AlecVercruysse/6thsense/paper/assets/ap1.pdf

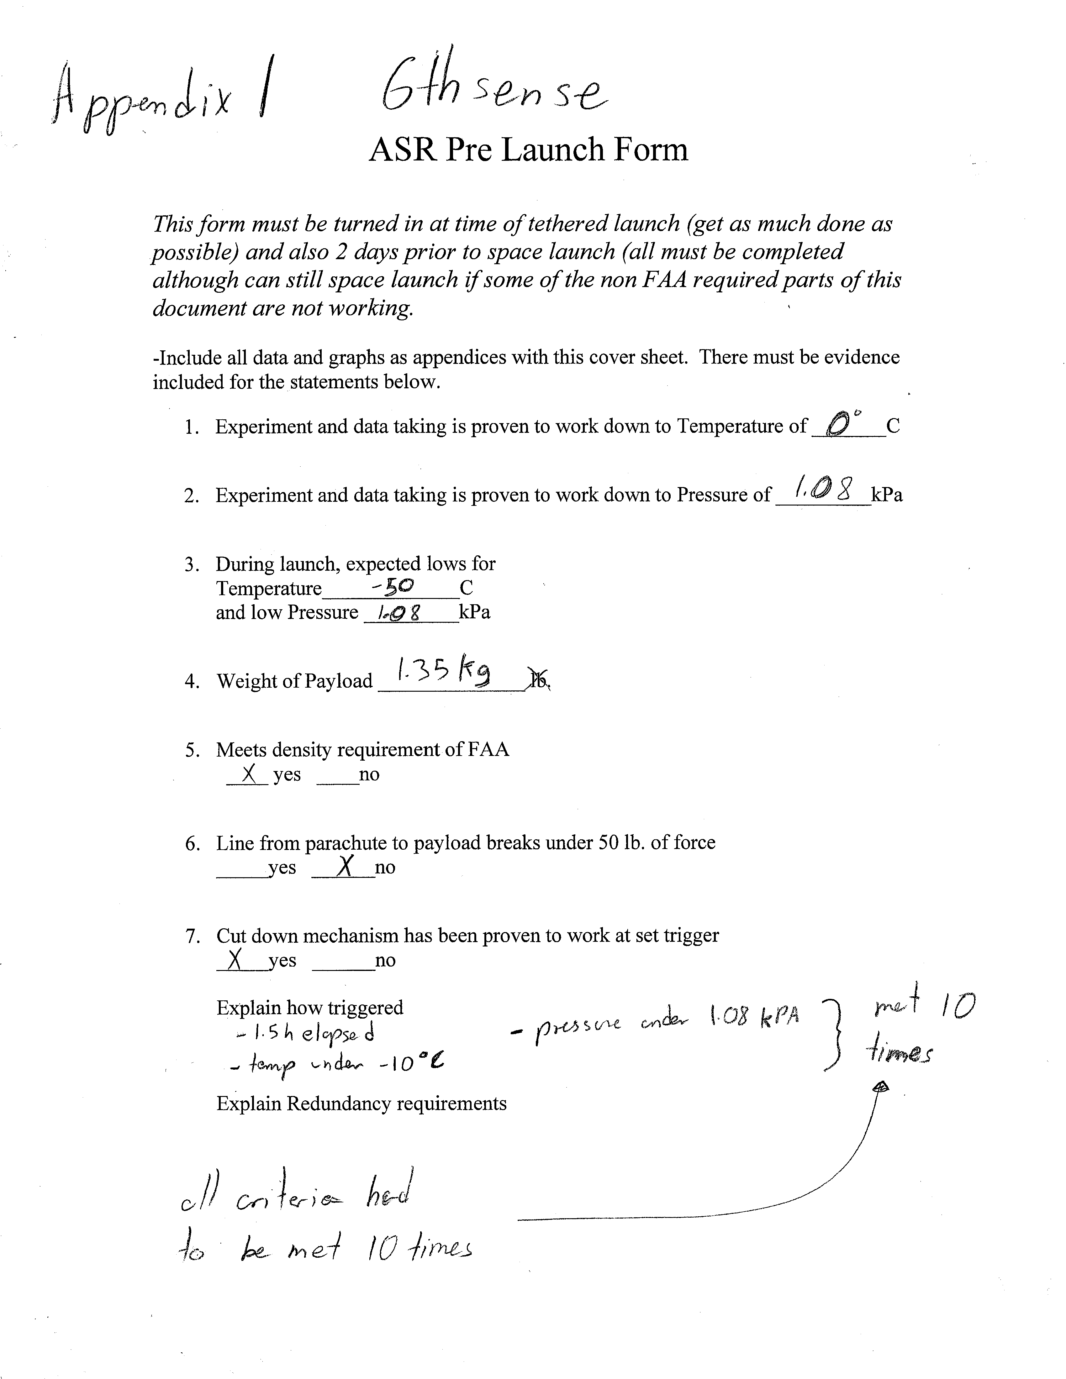
[picture p11: page 1]
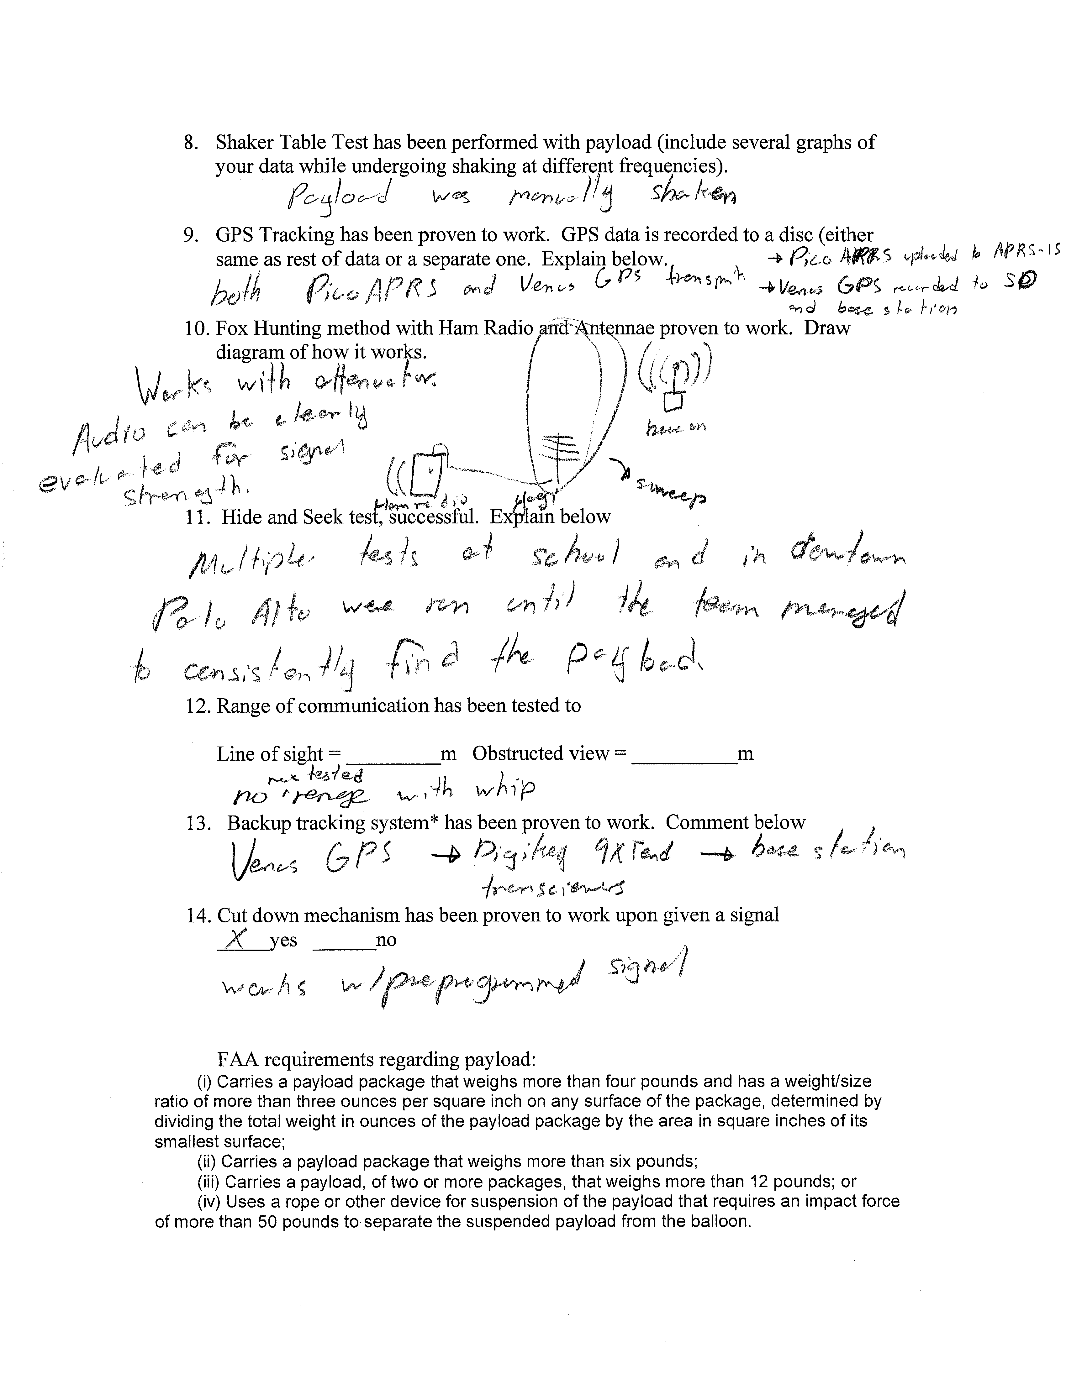
[picture p12: page 2]
