AlecVercruysse/6thsense/paper/assets/cad4.pdf

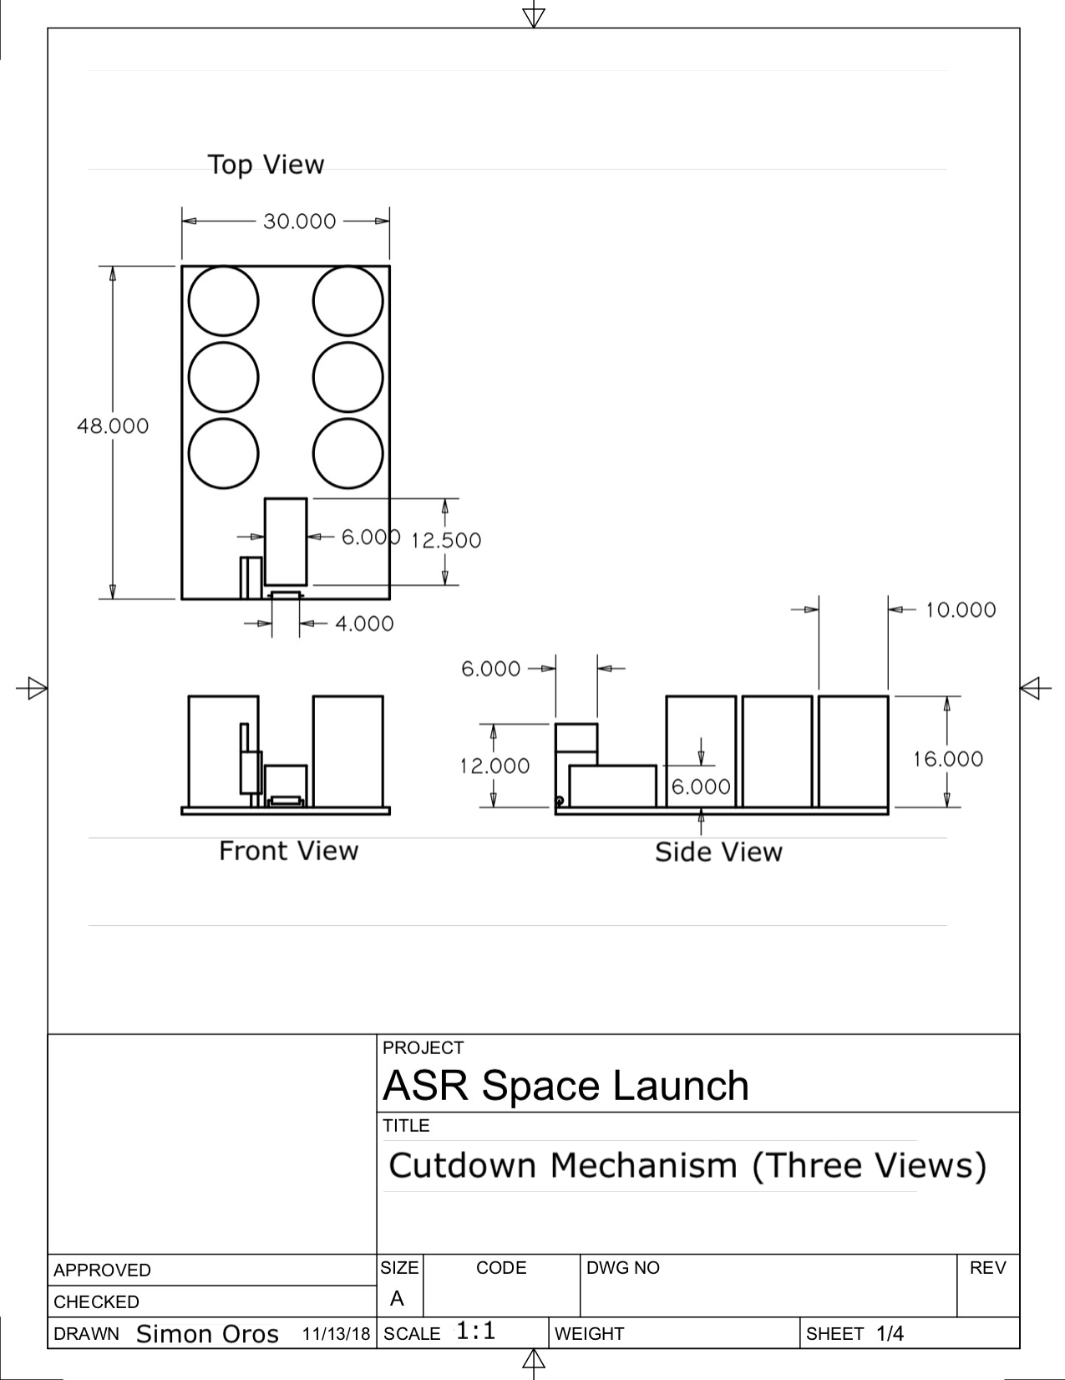
[picture p13: page 1]
