AlecVercruysse/6thsense/paper/assets/appendix2.png

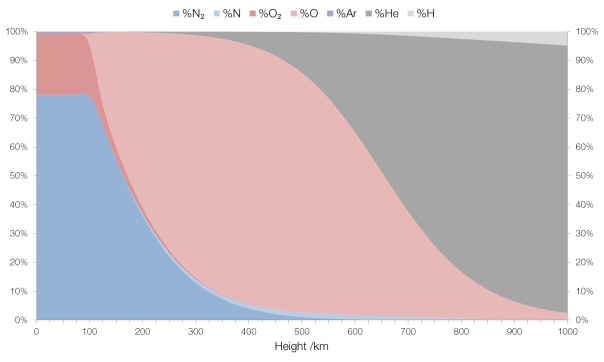
paper/assets/appendix2.png
