AlecVercruysse/6thsense/paper/assets/appendix3.png

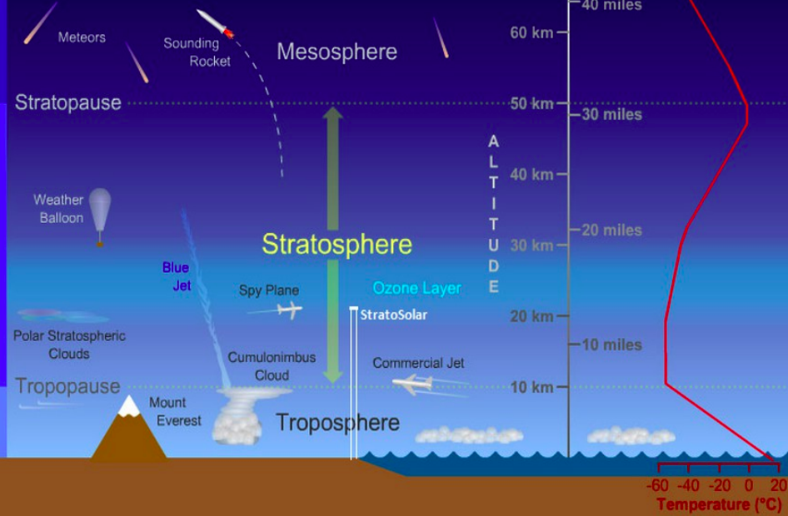
paper/assets/appendix3.png
