AlecVercruysse/6thsense/paper/assets/loop_flow.jpg

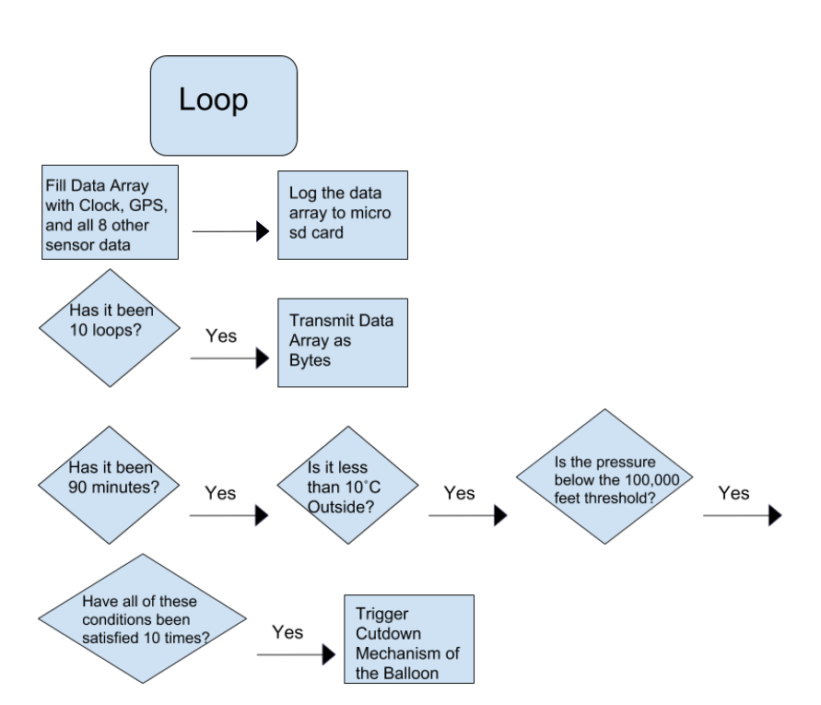
paper/assets/loop_flow.jpg
