AlecVercruysse/6thsense/paper/assets/nasa_model.gif

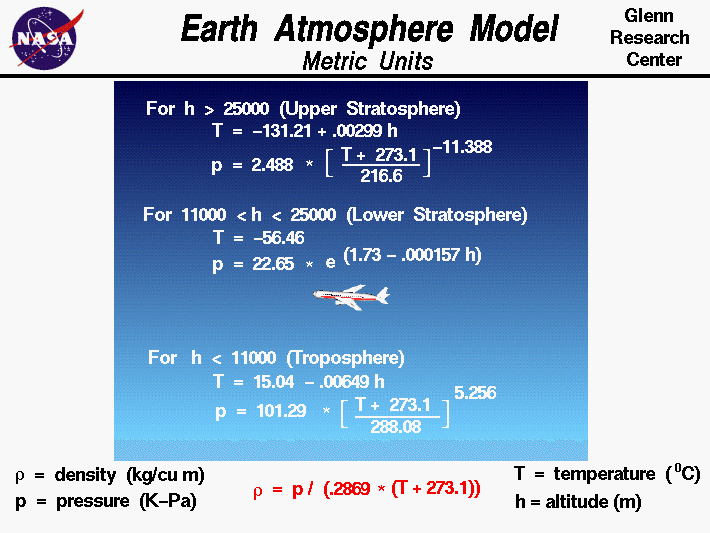
paper/assets/nasa_model.gif
