AlecVercruysse/6thsense/paper/assets/schematic.png

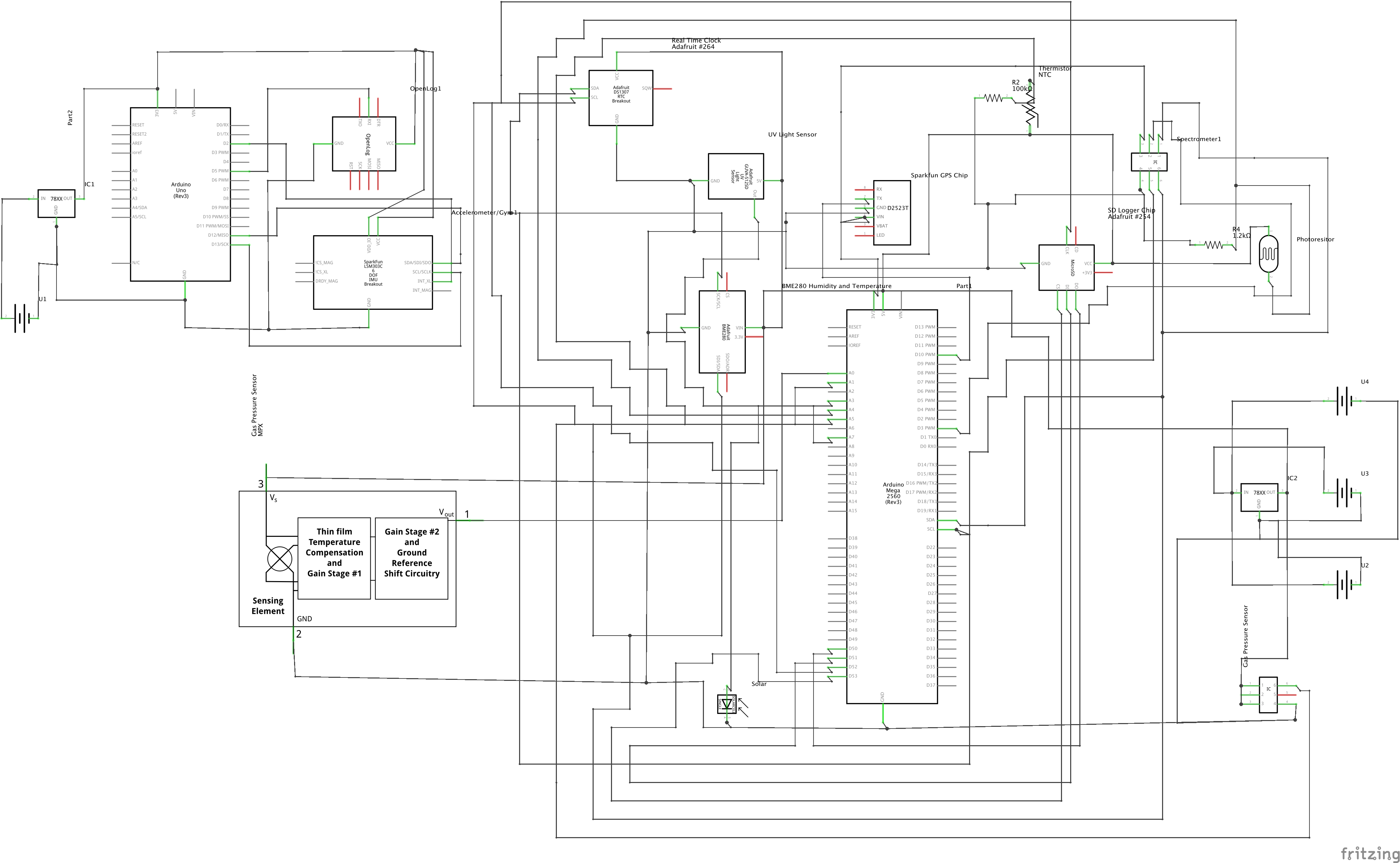
paper/assets/schematic.png
