AlecVercruysse/6thsense/paper/assets/setup_flow.jpg

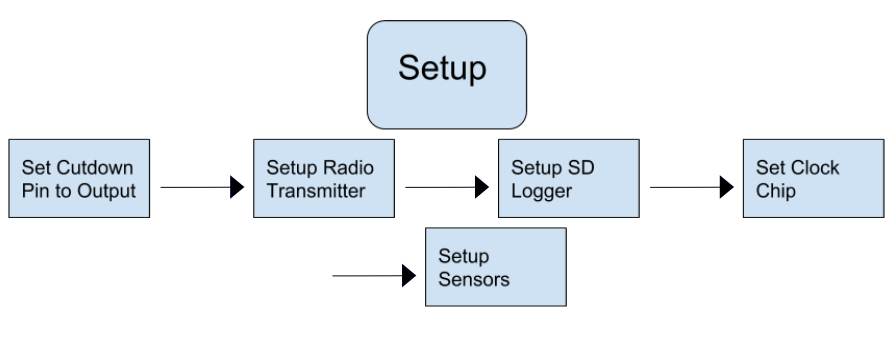
paper/assets/setup_flow.jpg
