AlecVercruysse/6thsense/basestation/radio_raw_test3.txt

0start
******14:51:47------Lat: 0000.0000N Long: 00000.0000E-------68.45------102.15------20.28------3.5-----23.5-----4>610:449.88680:19.56730:637.78760:5358810:59606860:418.24560:227.50585:249.0645:14505:1.290:166.90:108.0641024:0203383.521596--7-----5-----1-----1.000000*****14:51:4-----Lat: 0000.0000Long: 00000.000E-------68.45-----102.15------2027------37.83----.53-----250>61:445.47680:194.617:626.8476:528.815881860:409.750:226.01585:26.20645:14.05705:113.24900:163.1940:105.4102.4:790835:1591--6-----15---------1.00000****14:52:1------Lat: 000.0000N Long: 00000.0000E-------68.45----102.15-----20.21----39.11-----3.53------255>610:445.7680:193.62730:624.32760:527.1810:584.11860:408.79560:226.01585:245.72645:143.64705:113.24900:63.01940:1.384102.4:7903583.5:81591--7------16------1------1.000000******14:52:8------Lat: 0000.0000 Long: 0000.0000E-----65-----102.15------20.28------37.36------23.53-----26>610:447.6860:95.59730:632.73760:53.28810:591.79860:414.70560:227.00585:247.15645:144.46705:114.31900:165.3994:17.164102.4:8003383.5:8155--6------14-----1------1.00000******14:52:15----at: 0000.0000NLong: 00000.0000E-------68.45-----102.15-----2024------38.----23.53------265>610:449.88680:197.56730:642.8376:54373810:602.0480:422.97560:228.50585:249.065:145.27705:115.74900168.3690:108.95402.4:8003283.5:01599--6-----15--------1.00000******14:52:23------Lat: 00000NLong: 000000000E-------68.45------10215------20.34------37.03------23.53-----270>610:5.47680:961730:631.89760:534.28810:592.6860: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
