AlecVercruysse/6thsense/basestation/radio_runtime_test.txt

start
0------2.000000******12:3:32------Lat: 0000.0000N Long: 00000.0000E-------414.93------105.60------23.58-----37.67----21.25-----145>610:11.37680:136730:6.766.01810:11.10860:7.09560:58.24585:13.84645:8905:.090:1.19940:0.410:5.7443:14.55460:53555021572--------0-----0------2.000000*****12:3:39------Lat: 0000.0000N Long: 00000.0000E------476.35------105.88-----23.6-----37.70------21.35------150>0:11137680:13.76730:6.73760:6.01810:11.10860:709560:5.745813.846458.5975:7.50900:1.940:0.89410:57443:14.55460:5555021572------0----0-----2.00000******12:3:46------Lat: 0000000N Long: 00000.00E----446.08------105.-----23.-----3.62------2.5------155>61:111.37680:13.76730:6.73760.01810:11.10867.09560:58.74585:134648.5975:7.50900:1.19940:0.9410:5.735:1455460:53555021572-------0----------2.00000******1:353------Lat: 0000.000Long: 00000.0000E-------6.53-----106.24------2381-----37.42-----1.74------160>610:110.27680:12.78706.7760:6.01810:11.10860:7.09560:58.24585:13.84645:8.18705:7.50900:1.19940:0.89410:5.74435:14.55460:40555021572-------0------0------3.000000*****12:4:0------Lat: 0000.0000N ong: 00000.0000E-------429.32------105.32-----23.87-----37.32------21.44-----165>610:1.37680:1376730:6.760:6.01810110860:7.060:58.24585:13.84645:8.59705:7.50900:1.19940:0.89410:5.4435:14.55460:53555021572--------0------0------2.00000*****12:4:7------Lat: 00.0000N Long: 00000.0000E-------4371------105.85------3.88------37.25------21.74----170>610:111.37680:13.76730:7.57760:6.87810:11.10860:7.09560:58.74585:14.3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
