AlecVercruysse/6thsense/basestation/radio_raw_test2.txt

60105270.5:.--1------21------1782435:25.4640105270.5:.--1------21------17start
******20:49:0------Lat: 000.0000N Long: 00000.000E------145.90----103.09-----23.49-----8.07-----24.53-----175>6:620.8068:10.81730:1.6870:2.580:16.23860.73560167.7658645:8.59705:12.86900:.7890:0.89410:3.824355405270.5:.--1------21------17777*****20:49:7----Lat: 00000N Long: 000000000E------144.2------103.17------23.49------48.08------24.43------1180>610:620.80680:10.81730:1.68760:2.58810:16.23860:4.73560:167.76585:63.4645:.5975:2.86900:.78940:.410:3.82435:263740105270.5:.--1------21------17777*****20:49:14------Lat: 000.0000N Long: 00000.0000-------144.25-----03.07----23.49-----48.10-----24.43----1185>610:620.80680:10.81730:1.68760:2.58810:16.23860:4.7560:167.76585:63.46645:8.59705:12.86900:1.78940:0.8410:3.82432.374010527.5:.--1------20------17777******20:49:21------Lat: 0000.0000N Long: 00000.0000E-------141.79------103.09------23.51------8.0------24.43------1190>610:62080680081730:1.68760:2.58810:16.23860:4.50:167.76585:63.4664:8.59705:12.86900:1.78940:0.8910:3.82435:25.4640105270.5:.--1------21------177777******20:49:28-----Lat: 0000.0000 Long:00000.0000E-------14.25-----10.15------23.51------8.10------24.53---1195>610:619.69680:0.81730:1.687:2.58810:16.230:4.73560:167.76585:63.46645:8.59705:12.86900:1.78940:0.89410:3.82435:25.4640105270.5:.--1------21----166666******20:4:35------Lat: 000.0000N Long: 00000.0000E-------140.15------03.09------.55-----48.08------4.53-----1200>6106208068010.81730:168760:2.58810:16.23860:47360:167.76585:6.46645:8.597012.869:1.78940:0.89410:3.82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
