AlecVercruysse/6thsense/av_experiment/AS7265X_Dragonfly/spectrometer_csvout/heatshrink_measurements.csv

run | freq | val
81 | 610 | 13.23
81 | 680 | 1.97
81 | 730 | 0.84
81 | 760 | 0.86
81 | 810 | 0.85
81 | 860 | 0.00
81 | 560 | 5.97
81 | 585 | 1.91
81 | 645 | 2.46
81 | 705 | 0.36
81 | 900 | 0.00
81 | 940 | 0.00
81 | 410 | 1.91
81 | 435 | 3.64
81 | 460 | 3.74
81 | 485 | 6.67
81 | 510 | 3.20
81 | 535 | 4.30
82 | 610 | 13.23
82 | 680 | 1.97
82 | 730 | 0.84
82 | 760 | 0.86
82 | 810 | 0.85
82 | 860 | 0.00
82 | 560 | 5.97
82 | 585 | 1.91
82 | 645 | 2.46
82 | 705 | 0.36
82 | 900 | 0.00
82 | 940 | 0.00
82 | 410 | 1.91
82 | 435 | 3.64
82 | 460 | 3.74
82 | 485 | 6.67
82 | 510 | 3.20
82 | 535 | 4.30
83 | 610 | 13.23
83 | 680 | 1.97
83 | 730 | 0.84
83 | 760 | 0.86
83 | 810 | 0.85
83 | 860 | 0.00
83 | 560 | 5.97
83 | 585 | 1.91
83 | 645 | 2.46
83 | 705 | 0.36
83 | 900 | 0.00
83 | 940 | 0.00
83 | 410 | 0.96
83 | 435 | 3.64
83 | 460 | 3.74
83 | 485 | 6.67
83 | 510 | 3.20
83 | 535 | 4.30
84 | 610 | 16.54
84 | 680 | 1.97
84 | 730 | 1.68
84 | 760 | 1.72
84 | 810 | 0.85
84 | 860 | 0.00
84 | 560 | 6.97
84 | 585 | 4.29
84 | 645 | 5.32
84 | 705 | 0.36
84 | 900 | 0.00
84 | 940 | 0.00
84 | 410 | 1.91
84 | 435 | 7.27
84 | 460 | 8.41
84 | 485 | 11.43
84 | 510 | 17.62
84 | 535 | 5.01
85 | 610 | 219.43
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
