AlecVercruysse/6thsense/paper/assets/Yagi.pdf

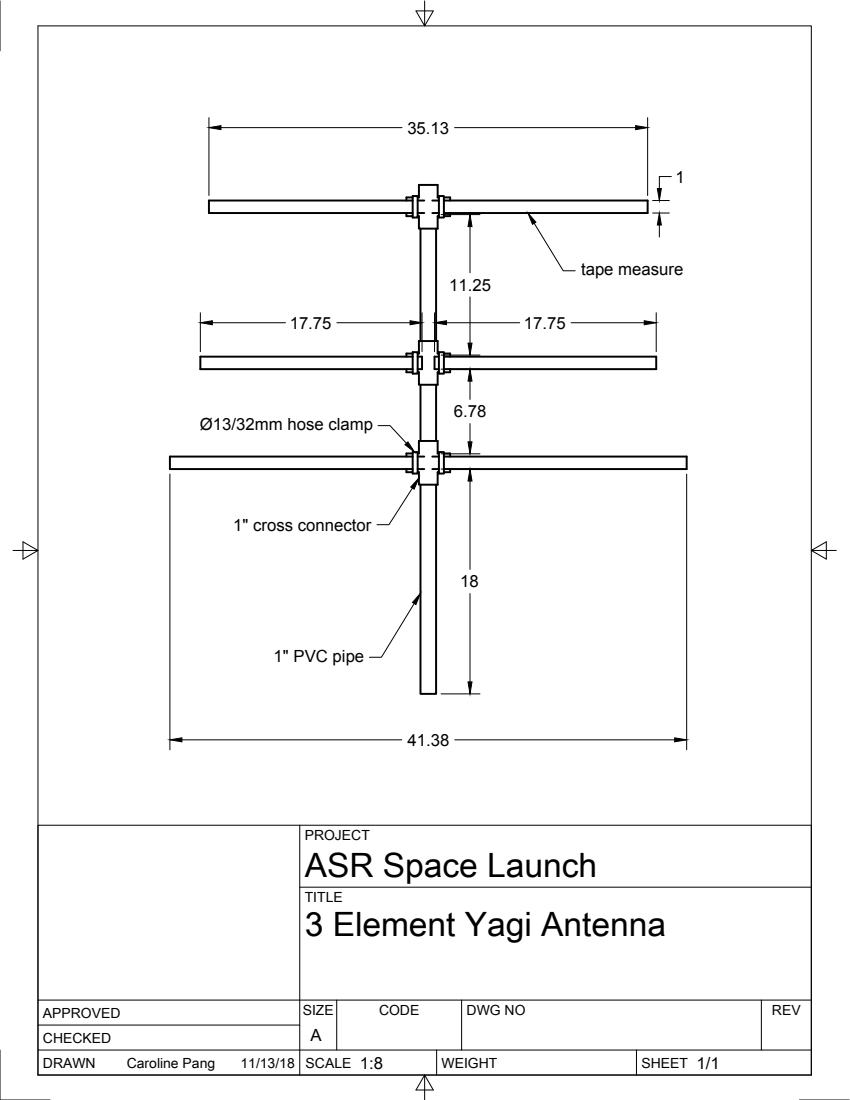
[picture p20: page 1]
SIZE; CODE; DWG NO; REV; Caroline Pang; 1" PVC pipe; 1" cross connector; tape measure; Ø13/32mm hose clamp

PROJECT
ASR Space Launch
3 Element Yagi Antenna
