AlecVercruysse/6thsense/paper/assets/reel_in.pdf

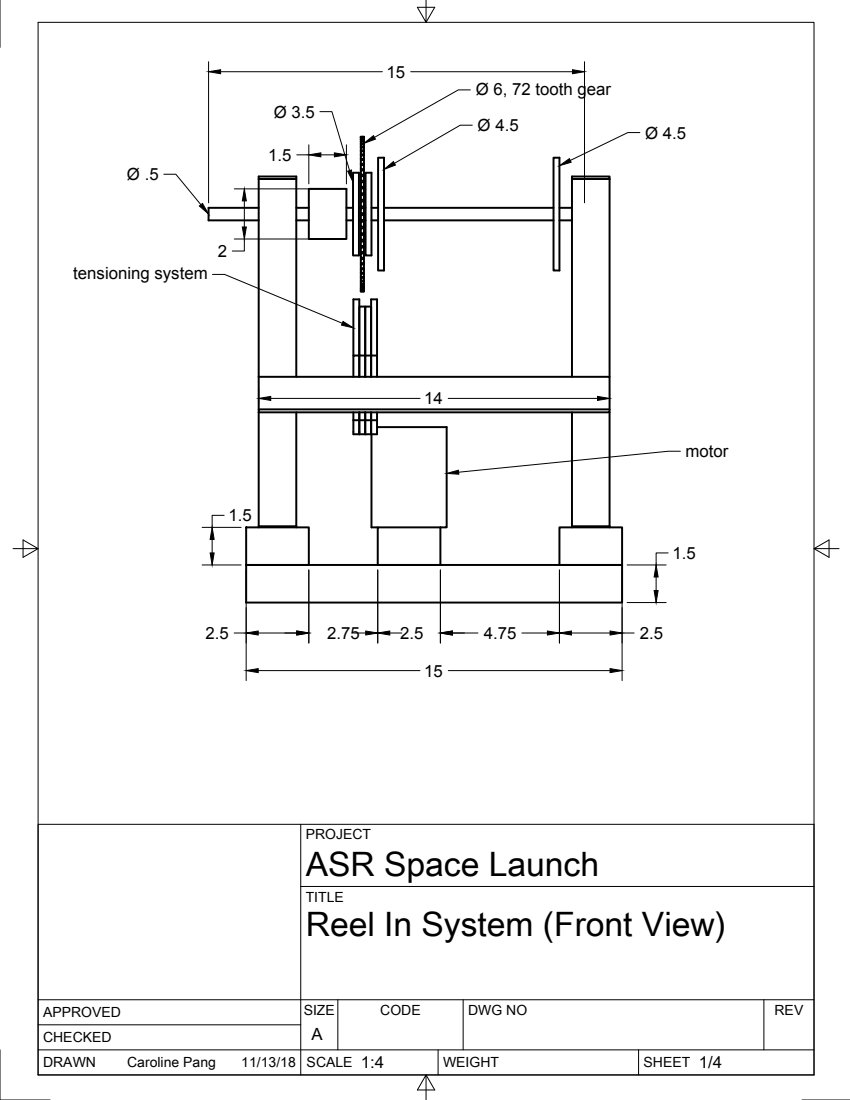
[picture p21: page 1]
SIZE; CODE; DWG NO; REV; Caroline Pang; tensioning system; Ø 6, 72 tooth gear

PROJECT
ASR Space Launch
Reel In System (Front View)

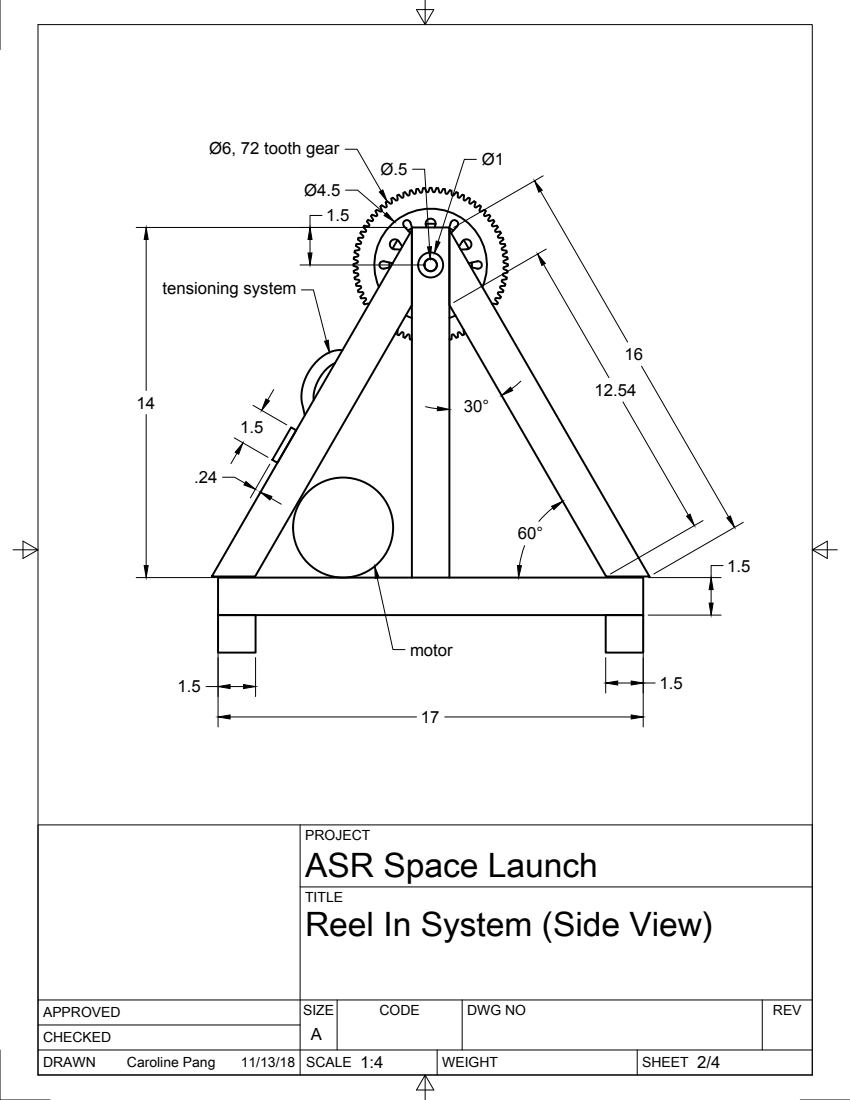
[picture p22: page 2]
Ø6, 72 tooth gear; tensioning system

PROJECT
ASR Space Launch
Reel In System (Side View)

SIZE | CODE | DWG NO | REV

Caroline Pang 11/13/18 | 1:4 | | 2/4

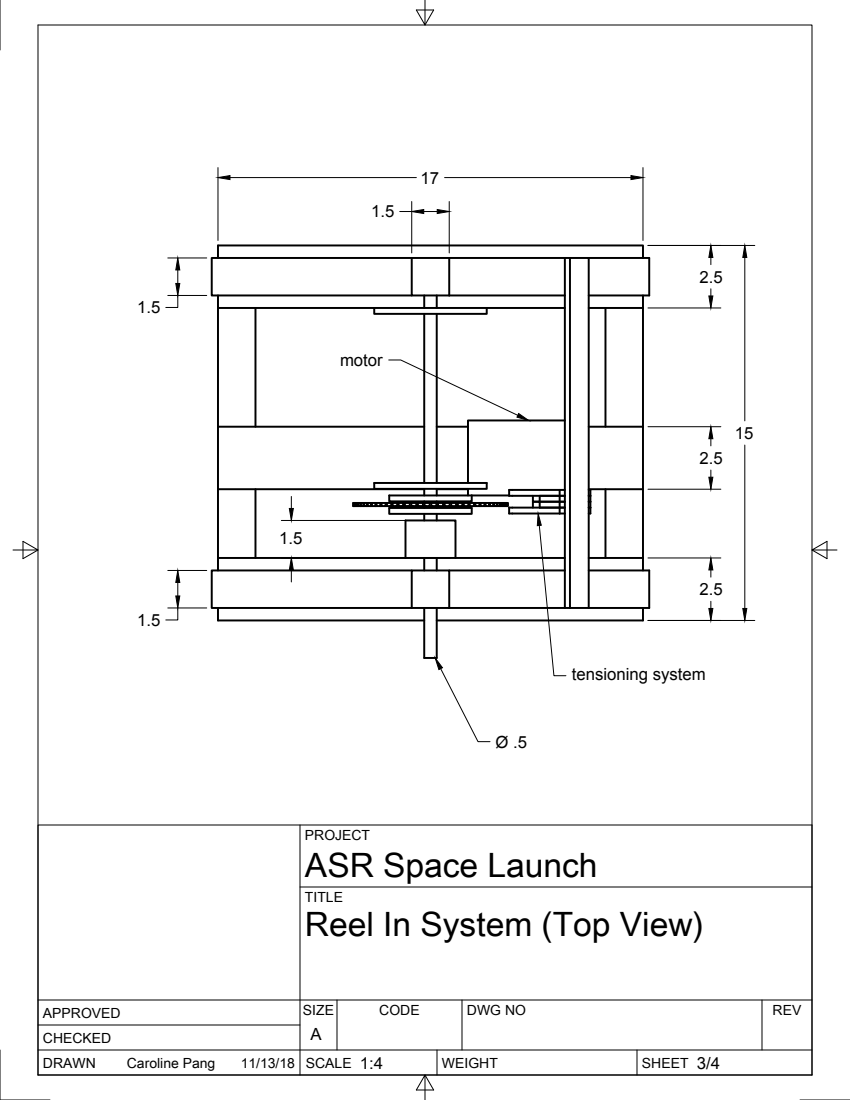
[picture p23: page 3]
tensioning system

PROJECT
ASR Space Launch
Reel In System (Top View)

SIZE | CODE | DWG NO | REV

Caroline Pang 11/13/18 | 1:4 | | 3/4

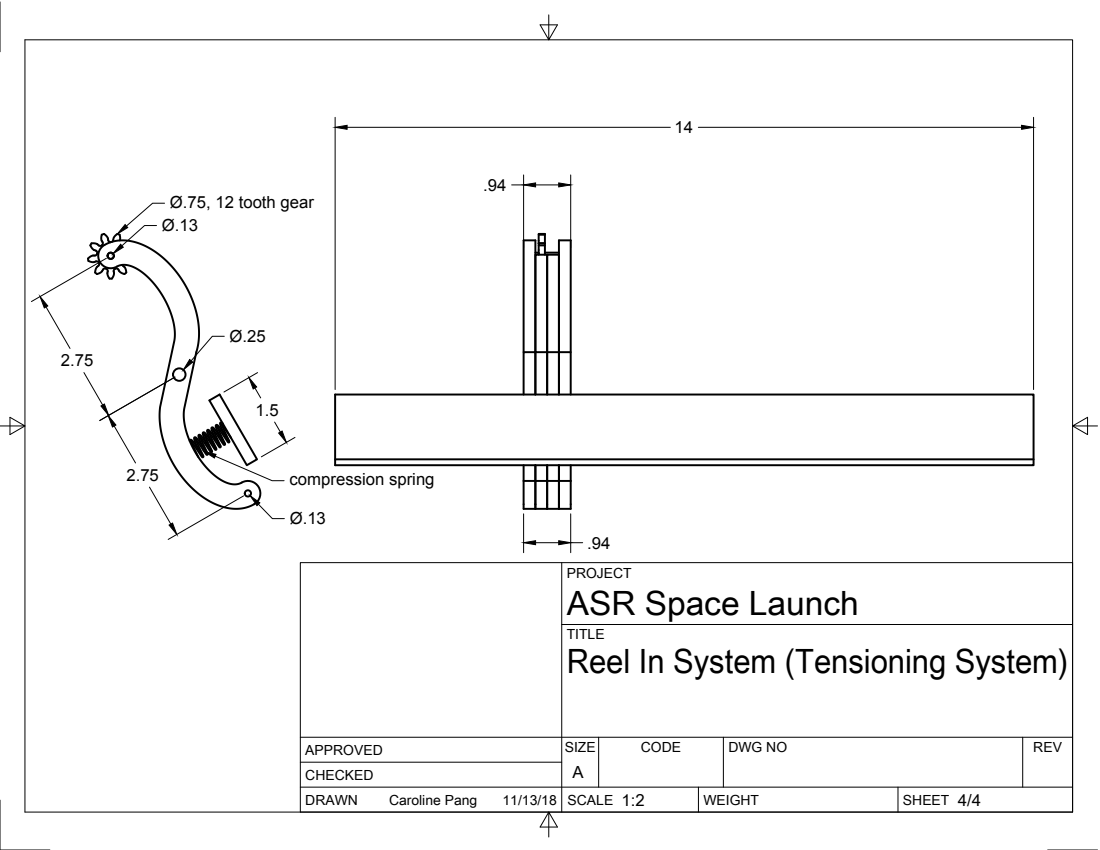
[picture p24: page 4]
SIZE; CODE; DWG NO; REV; Caroline Pang; Ø.75, 12 tooth gear; compression spring

PROJECT
ASR Space Launch
Reel In System (Tensioning System)
