AlecVercruysse/6thsense/paper/paper_files/figure-latex/bme-1.pdf

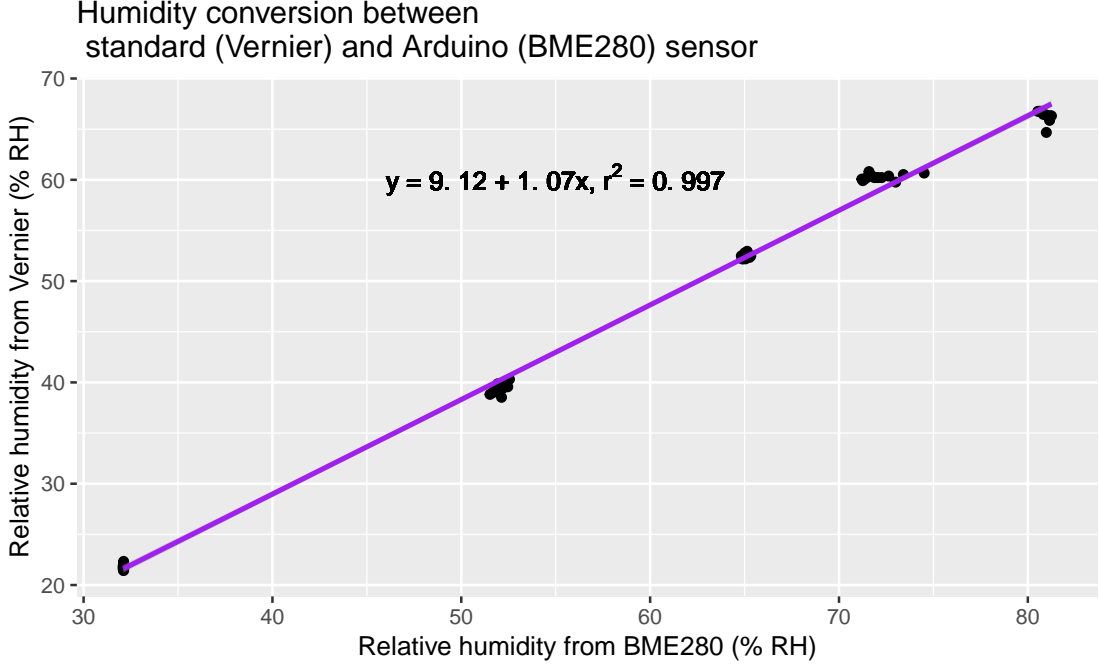
[picture p25: page 1]

Humidity conversion between
standard (Vernier) and Arduino (BME280) sensor

Relative humidity from Vernier (% RH)

Relative humidity from BME280 (% RH)
