AlecVercruysse/6thsense/paper/paper_files/figure-latex/bme_temp-1.pdf

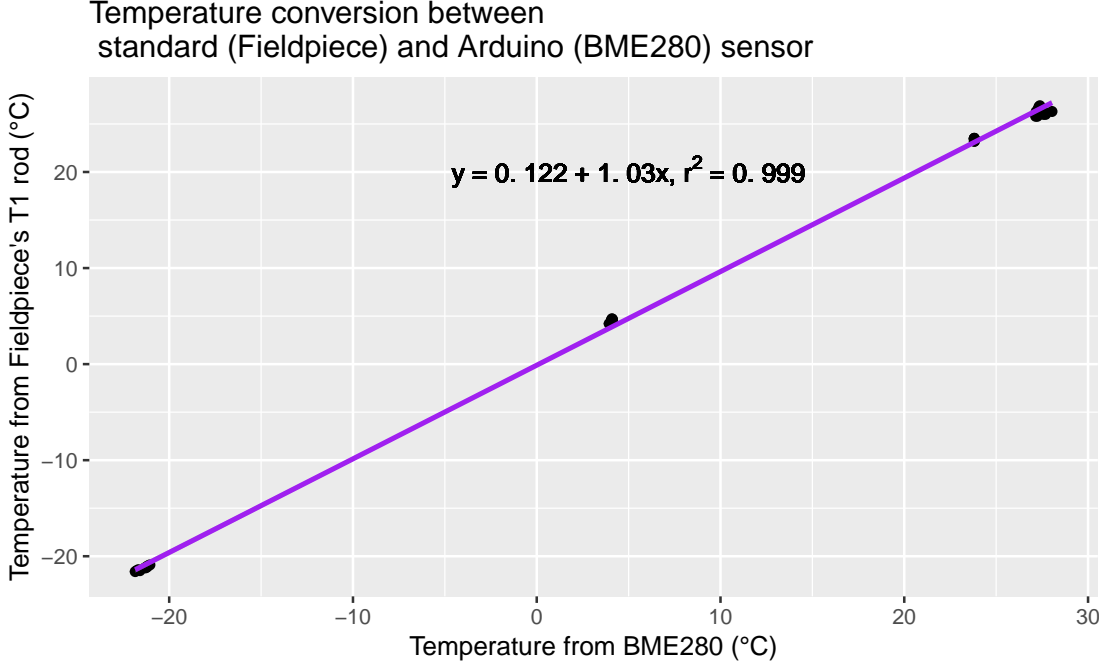
[picture p26: page 1]
Temperature from BME280 (°C)

Temperature conversion between
standard (Fieldpiece) and Arduino (BME280) sensor

Temperature from Fieldpiece's T1 rod (°C)
