AlecVercruysse/6thsense/paper/paper_files/figure-latex/temp2-1.pdf

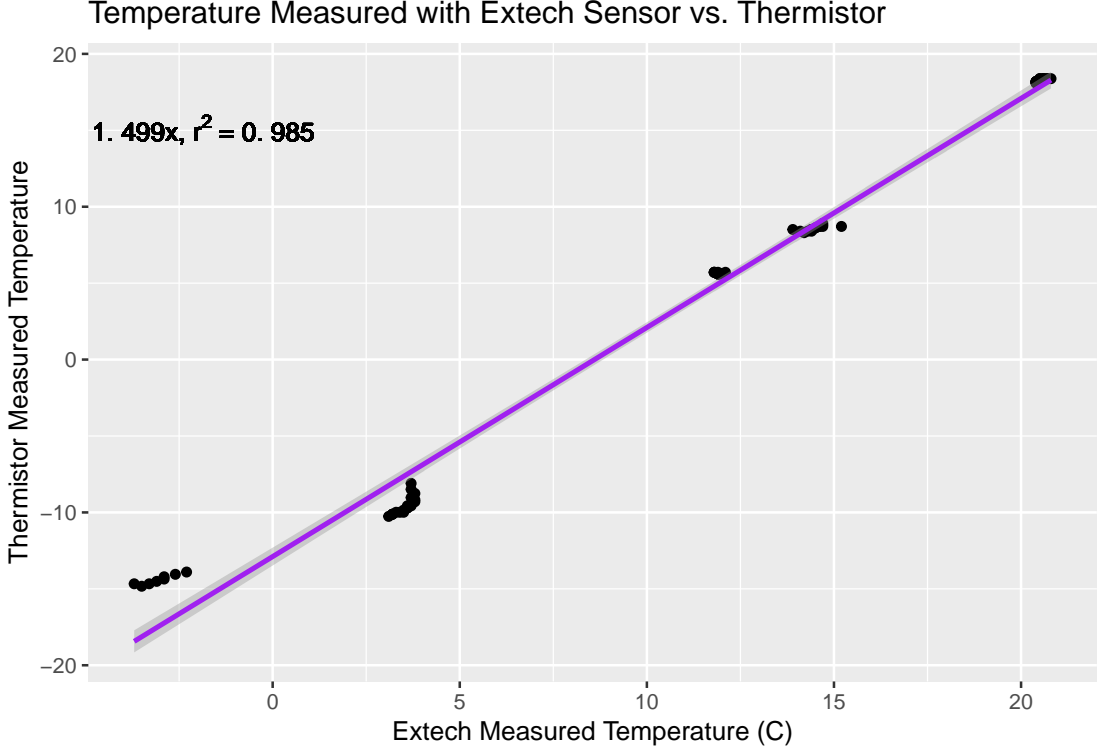
[picture p27: page 1]

Temperature Measured with Extech Sensor vs. Thermistor

Thermistor Measured Temperature

Extech Measured Temperature (C)
