AlecVercruysse/6thsense/paper/paper_files/figure-latex/temp_altitude-1.pdf

## Calculated External and Measured Internal Temperature vs. Height

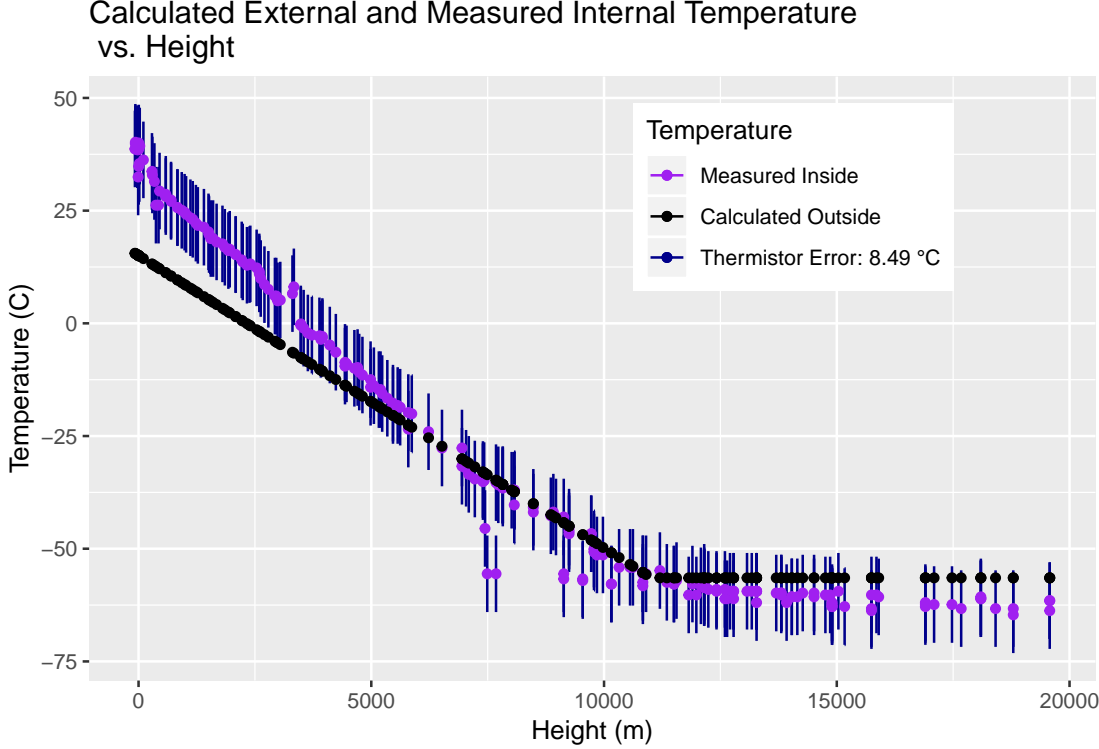
[picture p28: page 1]
Height (m); Temperature (C); Temperature; Measured Inside; Calculated Outside; Thermistor Error: 8.49 °C
