AlecVercruysse/6thsense/paper/paper_files/figure-latex/vernier_calibration-1.pdf

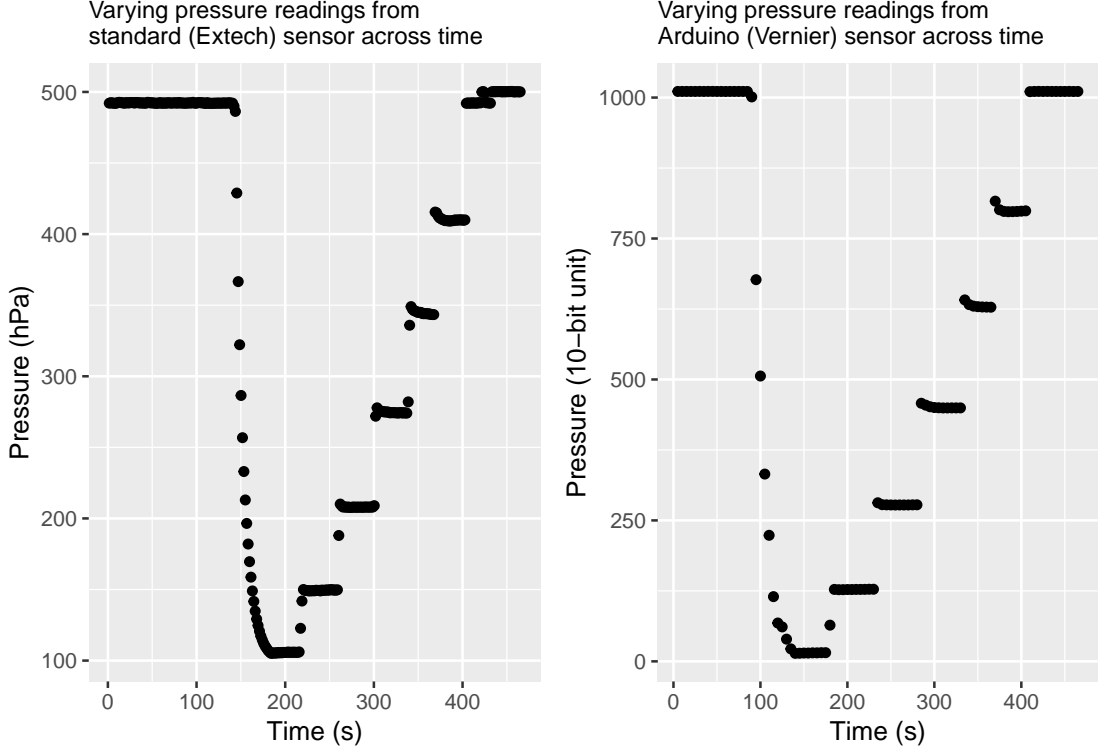
[picture p29: page 1]
Time (s); Pressure (hPa)

Varying pressure readings from
standard (Extech) sensor across time

Arduino (Vernier) sensor across time

Pressure (10−bit unit)
