AlecVercruysse/6thsense/paper/assets/schematic.pdf

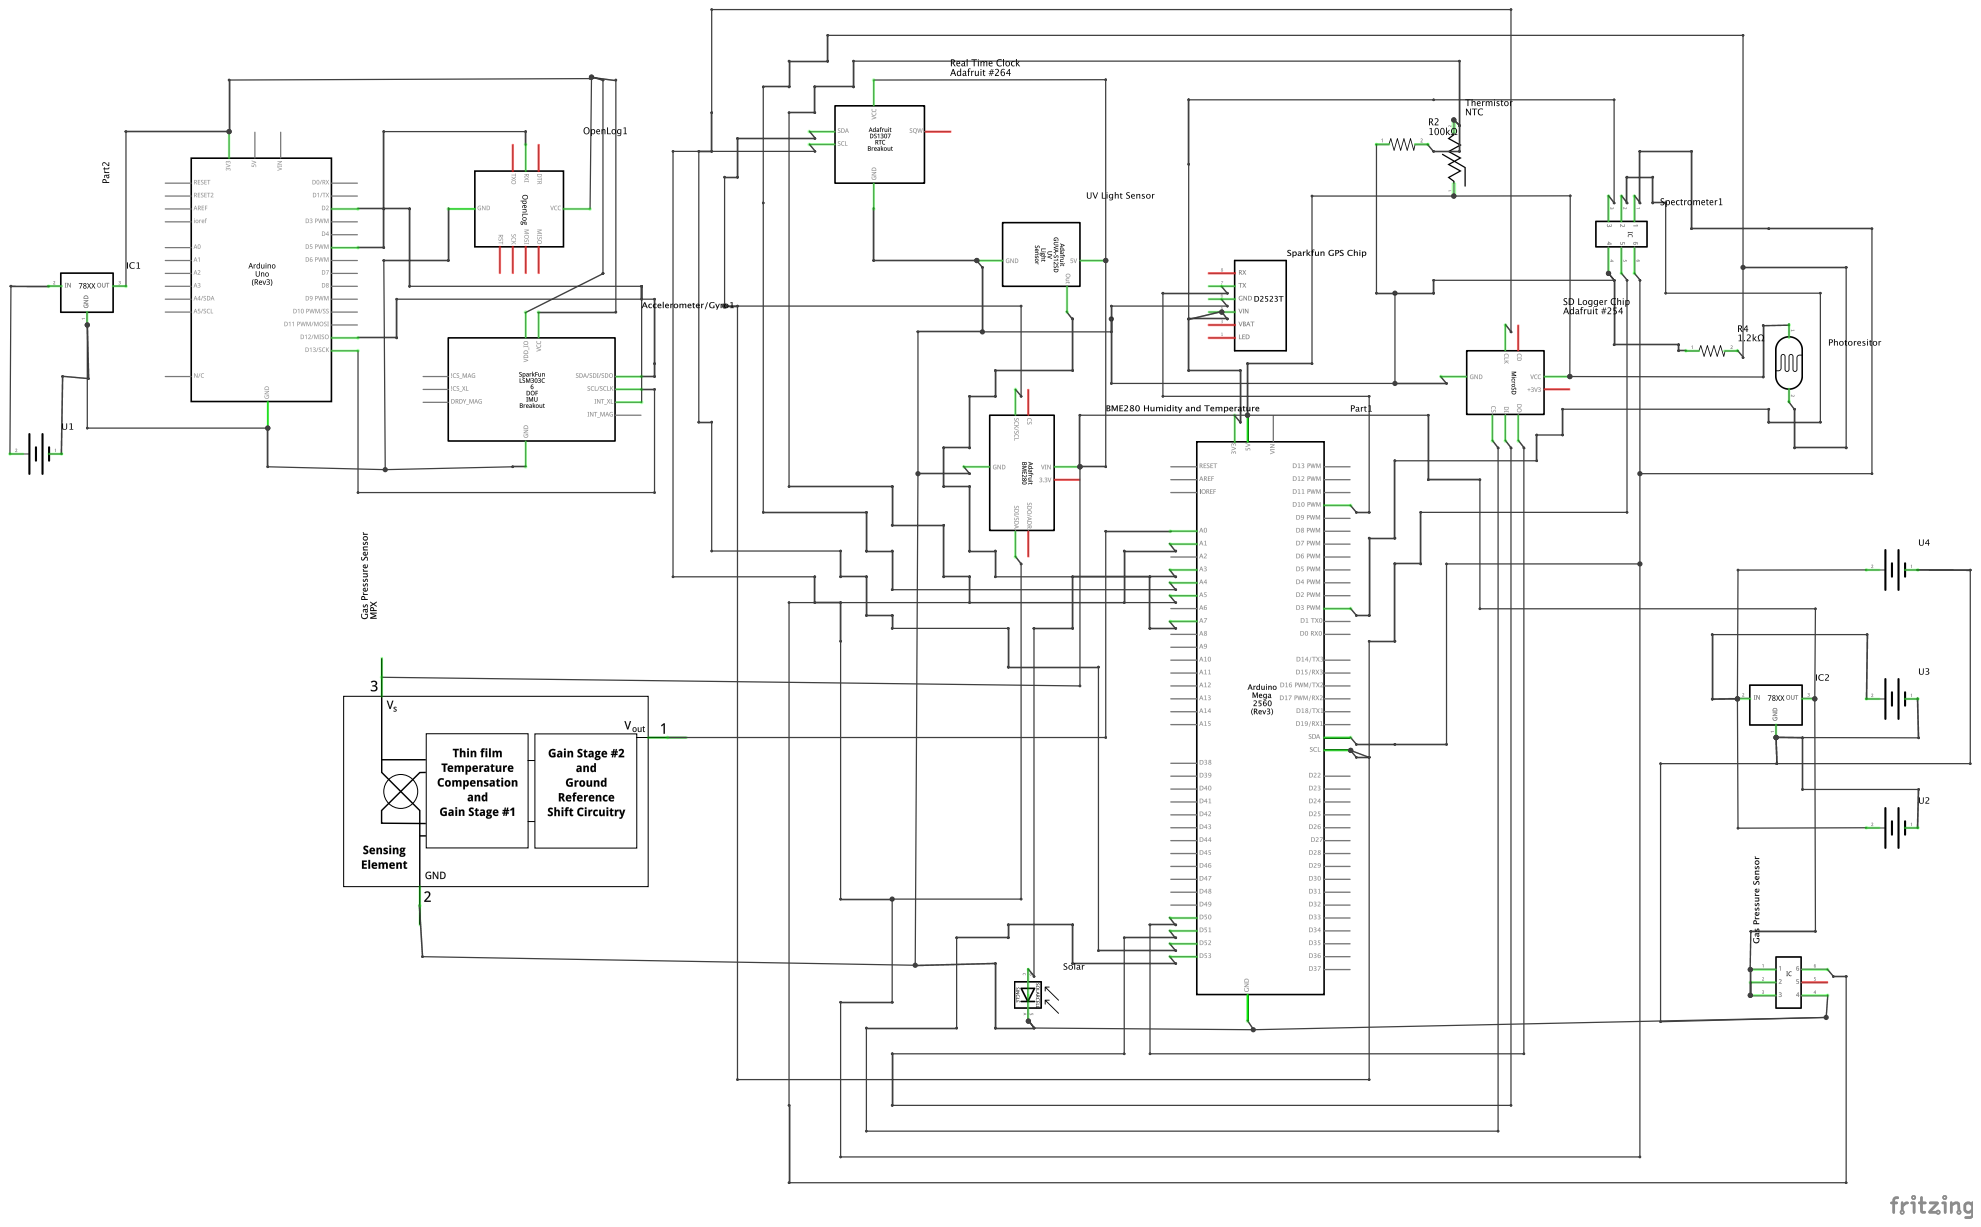
[picture p30: page 1]
