AlecVercruysse/6thsense/paper/assets/cad1.pdf

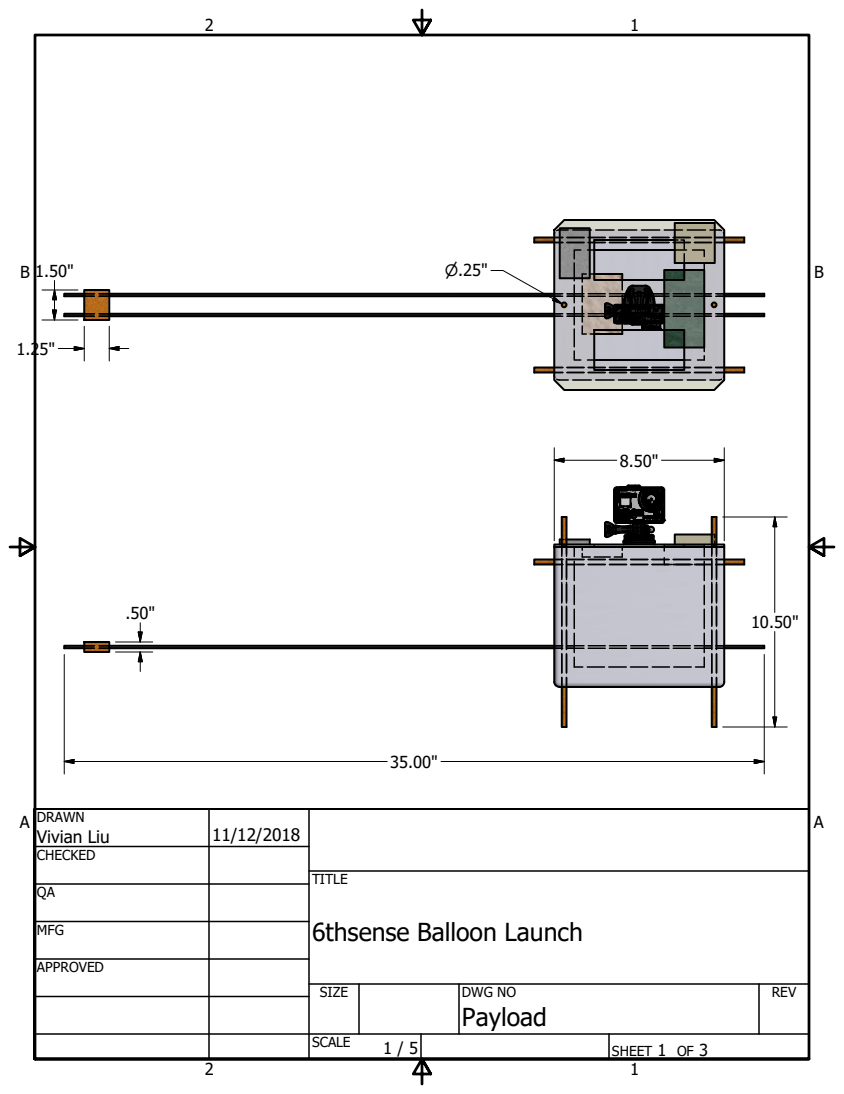
[picture p31: page 1]
SHEET 1 OF 3; Vivian Liu; DWG NO; 6thsense Balloon Launch
