AlecVercruysse/6thsense/paper/assets/cad2.pdf

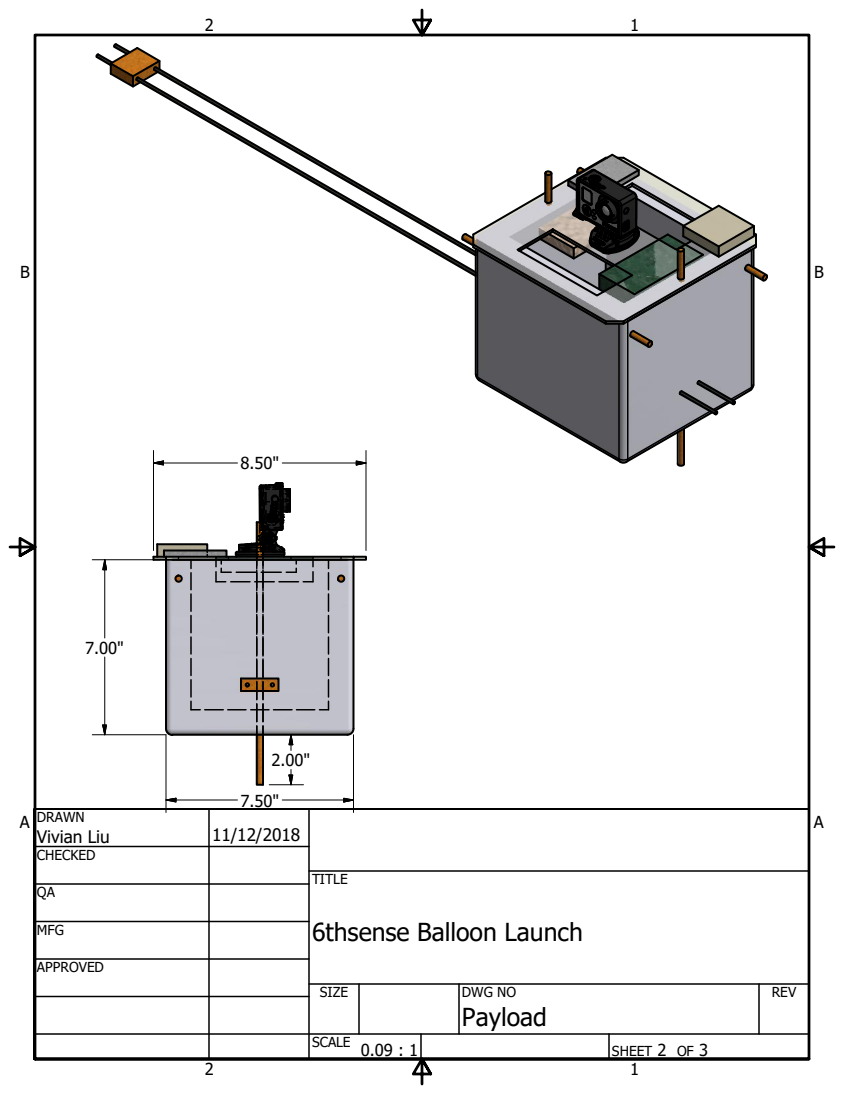
[picture p32: page 1]
6thsense Balloon Launch

DRAWN Vivian Liu | 11/12/2018

CHECKED

MFG

APPROVED

SIZE | DWG NO Payload | REV

SCALE 0.09 : 1 | | SHEET 2 OF 3
