AlecVercruysse/6thsense/paper/assets/cad3.pdf

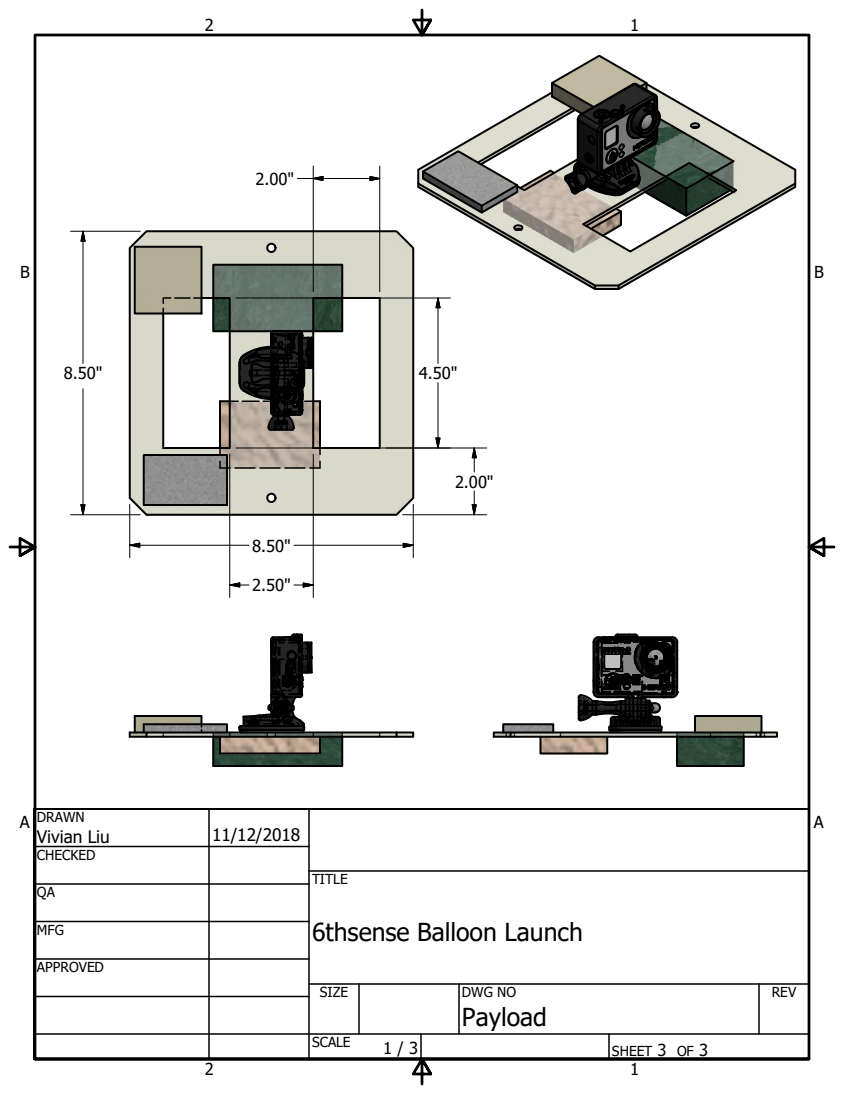
[picture p33: page 1]
SHEET 3 OF 3; Vivian Liu; DWG NO; 6thsense Balloon Launch
