AlecVercruysse/6thsense/paper/paper_files/figure-latex/altitude"-1.pdf

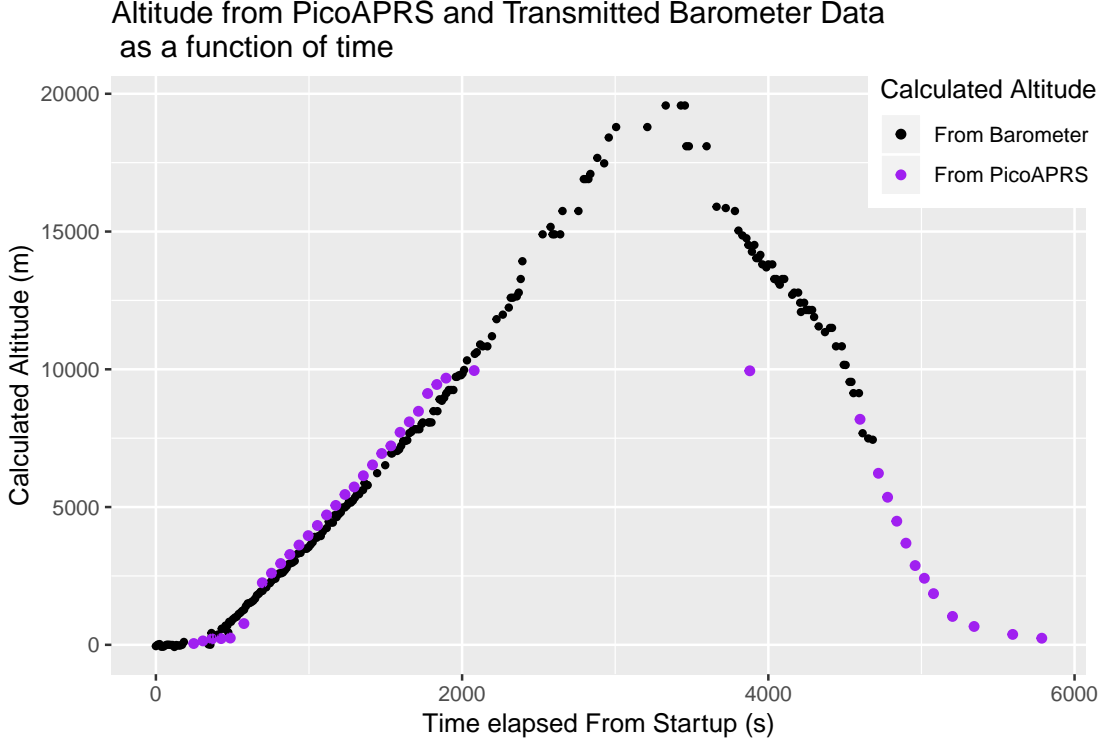
[picture p34: page 1]
Calculated Altitude (m); Calculated Altitude; From Barometer; From PicoAPRS

Altitude from PicoAPRS and Transmitted Barometer Data
as a function of time

Time elapsed From Startup (s)
