AlecVercruysse/6thsense/(commit log)

2018-10-01 Prints GPS coordinates
2018-10-02 reads temperature in celsius and F
2018-10-11 test spectrometer
    [heatshrink_measurements.csv]
2018-10-16 added pressure sensor gathering and renamed logger.h to sensors.h
2018-10-17 base station prints lines to serialOut
2018-10-17 bugfixes, formatting, and testing
    [final_balloon.ino, sensors.h, spectrometer.h, tx.h]
2018-10-17 enable all transferred sensors on main file. need to change getGPS()
2018-10-17 added case for when gps is not available
2018-10-17 took out commented code and changed pressure to report in kPa
2018-10-18 got gps working and added some pressure stuff
2018-10-18 changed some pressure stuff in final balloon
2018-10-18 add sensors library
2018-10-18 changed final balloon and sd logger to incorporate johns sensors
2018-10-18 changed cutdown pin number
2018-10-19 lots of fixes\n\n barometer: return avg of 10 readings. try to integrate humidity.h. add RTCLib to local. some commenting and reformatting and messing around with #includes. Should only have 1 wire.b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
    [final_balloon.ino, humidity.h, sd_logger.h, sensors.h]
2018-10-21 PRESSURE PIN WAS WRONGgit statusgit status
    [radio_parser.py, sensors.h]
2018-10-22 changed pressure equation
2018-10-24 get compiling again and debug logging issues. Currently having issues with 3.3v spectrometer on the i2c bus, which stops anything from logging
    [sensors.h, spectrometer.h]
2018-10-24 setup radio parser for new dataarr, turn off spectrometer LED
2018-10-24 turns out the interrupt number is not necessarily the pin... on a mega the pin for interrupt #3 is 20, the i2c bus. fixed
    [spectrometer.h]
2018-10-24 changed accelerometer code so that it should hopefully work with final balloon
2018-10-24 took out wire begin and changed the data array to get accelerometer data
2018-10-24 added accelerometer libraries
2018-10-24 fixed compilation errors. moved accelerometer code to single subdirectory
    [accelerometer.h, final_balloon.ino]
2018-10-24 get pressure working??
2018-10-24 get spectrometer woroking on 5v bus???? (magic) also important altitude calc edits
2018-10-25 change pressure to cutdown
2018-10-26 print rssi and gps from 2nd basestation arduino
2018-10-26 added accelerometer functionality
2018-10-26 Upload Secondary Arduino Code
2018-10-27 moved accelerometer to secondary arduino and updated secondary to include accelerometer and final balloon to not include accelerometer
2018-10-27 re added accelerometer to work with secondary arduino
2018-10-27 took out all mentions of serial from accelerometer.h
2018-10-29 create instructions for live monitoring software.
    there are definitely better ways to get the serial ports our arduino is running on... Probably should use the arduino ide instead.
2018-10-29 changed accelerometer stuff to include more libraries so it actually compiles
2018-10-30 got accelerometer and geiger to work with limited testing
2018-10-30 test radio parser... fails
    [radio_parser.py]
2018-11-01 Update final_balloon.ino
    Last minute change to the pressure cutdown value. Used to be 108KPa (wrong). It is now 1.08KPa.
    [final_balloon.ino]
2018-11-02 upload exported arps data
    [aprsfi_export_N6MLO-9_20181031_181304_20181102_181304.csv]
2018-11-13 start knitting paper
    [errors.csv, humidity1.csv, pressure1.csv, pressure2.csv, pressure3.csv, temp1.csv]
2018-11-14 almost done with paper
    [aprs.csv, pv.csv, temp2.csv]
2018-11-14 error bars
    [errors.csv]
2018-11-14 changed appendix reference for schematic
2018-11-20 into csv
    [parsed_a_bit.csv]
2018-12-15 Added inviidual project on measuring CO2 concentrations in the Bay Area
    [37.2796, -122.07358.csv, 37.3, -122.0746.csv, 721 w remington.csv, HOME.csv, atherton school.csv, bj stop.csv, cupertino sports center.csv, fremont high school.csv]
